dfvella/autopilot/tools/thr000_noise.png

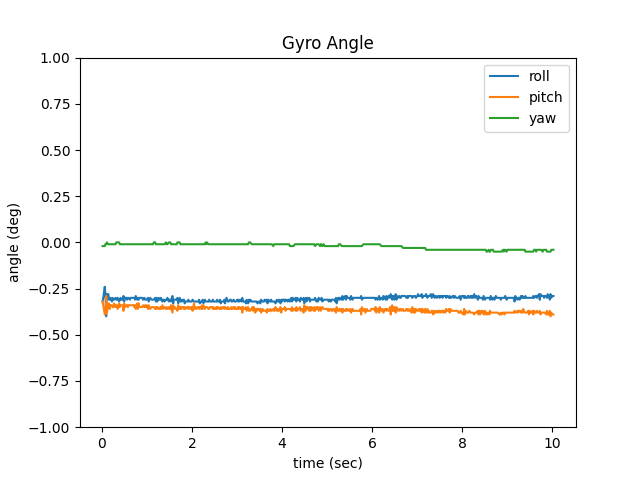
tools/thr000_noise.png
