dfvella/autopilot/tools/thr045_noise.png

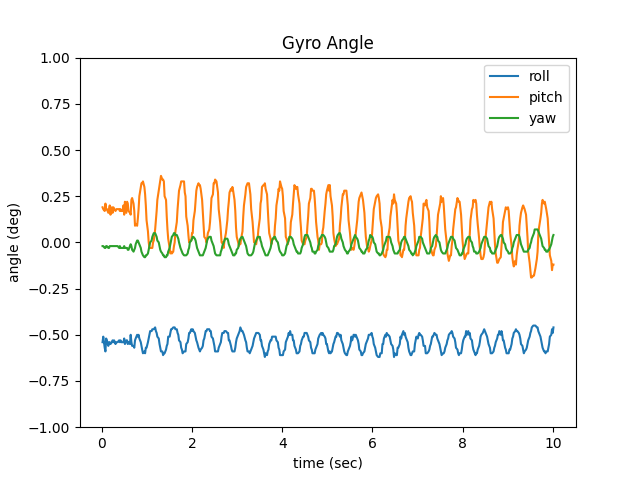
tools/thr045_noise.png
