dfvella/autopilot/tools/thr100_noise.png

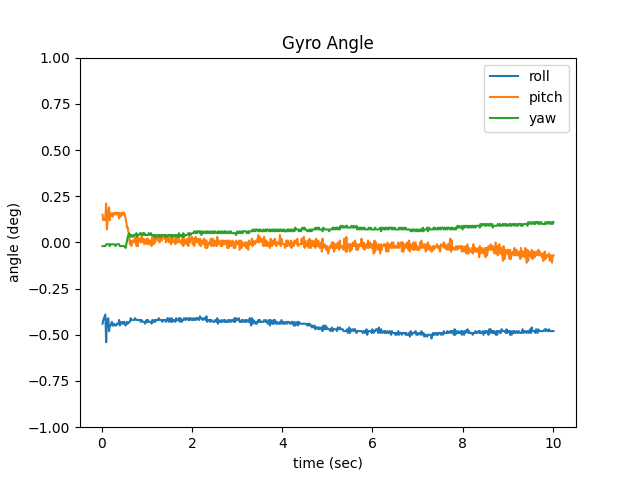
tools/thr100_noise.png
