dfvella/autopilot/autopilot/pid.h

/* 
 * PID controller class for calculating the servo output signal /
 * control surfrace deflection based on current imu readings.
 */

#ifndef PID_H
#define PID_H

#include <Arduino.h>

#define MICROSEC_PER_SEC 1000000.0

class PIDcontroller
{
    public:
        PIDcontroller(float p_in, float i_in, float d_in, float i_max_in);
        float calculate(float error);

    private:
        float p, i, d, i_max;
        float i_output, prev_output, prev_error;

        unsigned long timer;
};

#endif
