dfvella/autopilot/(commit log)

2020-03-24 Added accelerometer calibration procedure
2020-03-28 Switched to integration by trapazoidal rienmann sums
2020-04-04 Getting correct pitch roll and yaw angles
    [imu.cpp, imu.h]
2020-04-04 Fixed problem causing not accurate roll pitch and yaw angles
    [imu.cpp, imu.h]
2020-04-05 Encapsulated Mpu6050 class inside of Imu class
2020-04-07 Added anti gyro drift filter
    [imu.cpp, imu.h]
2020-04-10 Moved attachInterupt outside of ppmDecoder class
2020-04-17 status led pin now a constructor parameter
2020-04-18 PWM signal schedular working
2020-04-18 Moved pwm schedular into class
2020-04-18 Disabled telemetry checking, not working
    [ppm.cpp, ppm.h]
2020-04-20 Added PID output logging
2020-04-20 Added get method for servo signal logging
2020-04-29 Disabled drift filter, needs work
    [imu.h]
2020-05-03 Reversed right bot and left top servos
    [servo.h]
2020-05-03 Moved pins down one and constrained servo map output
2020-05-08 Fixed and tuned pid controllers
2020-05-08 Added autoclimb mode and pid target trims
2020-05-16 moved PIDcontroller to servo files
2020-05-16 Added raw gyro and accel logging
2020-05-18 Fixed pid output logging
    [logging.h]
2020-05-18 Fixed unsigned int return causing pid output bug
    [ppm.cpp, ppm.h]
2020-05-21 Reduce noise in servo output
    [servo.cpp]
2020-05-22 Moved servo mixes to seperate file
2020-05-23 Moved pid controller to seperate file
2020-05-28 Tuned pid and autoclimb to reduce oscillations
2020-06-04 Fixed bug allowing servos to collide
2020-06-07 Calibrated Accelerometer
2020-06-07 Added fast imu startup mode
2020-06-07 Tuned pid for oscillations
2020-06-12 tuned pid controller again
2020-06-20 Added wire diagram
2020-07-05 Replaced if else with swtich
    [autopilot.ino]
